Alejo-end/midiguitar/reins-guitar/renders/reins-guitar-bottom.png

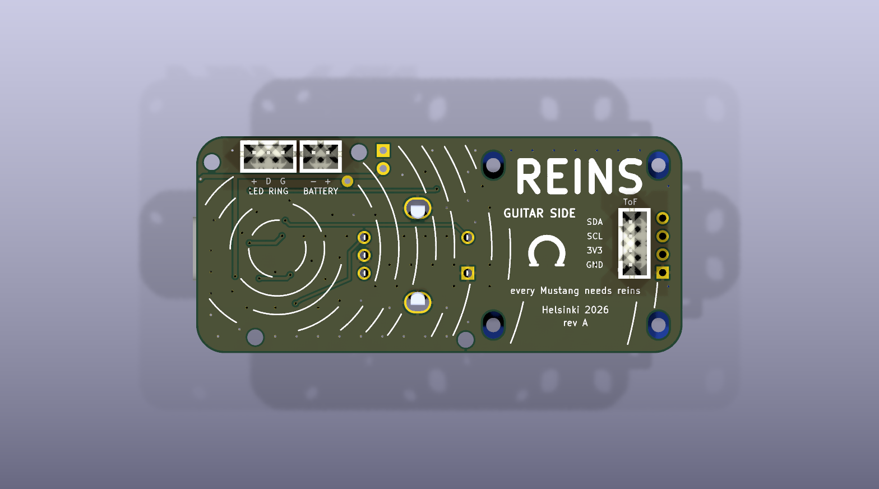
reins-guitar/renders/reins-guitar-bottom.png
