Alejo-end/midiguitar/reins-guitar/fab/jlc/reins-guitar/reins-guitar-bom.csv

Comment | Designator | Footprint | LCSC
100k | R4,R5 | R_0603_1608Metric | C25803
100nF | C1,C2,C4,C5 | C_0603_1608Metric | C14663
22uF | C3 | C_0805_2012Metric | C45783
330 | R1 | R_0603_1608Metric | C23138
B5819W | D1,D2 | D_SOD-123 | C8598
SN74LVC1T45DBVR | U1 | SOT-23-6 | C7843
