Alejo-end/midiguitar/cad/cad-midiguitar-guitar_043 (Solid)001.step

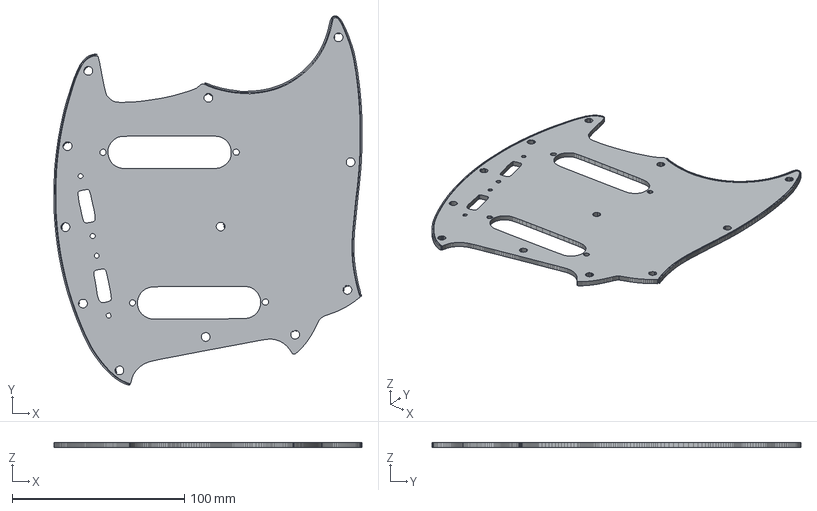
[picture p4: CAD file, 2026-05-04]
cad/cad-midiguitar-guitar_043 (Solid)001.step
179.0 x 214.4 x 3.00 mm
