Alejo-end/midiguitar/pcb/finalMidiGuitar.step

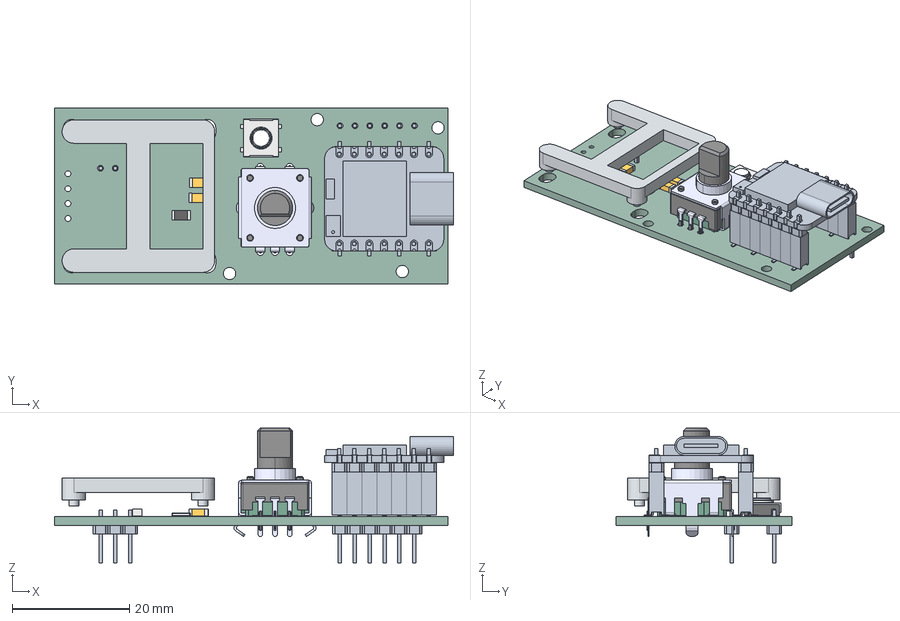
[picture p5: CAD file, 2026-05-04]
pcb/finalMidiGuitar.step
68.0 x 29.9 x 23.0 mm
Contact x 3
ContactClone x 3
finalMidiGuitar 1.2.1
finalMidiGuitar 1.2.2
finalMidiGuitar 1.2.3
finalMidiGuitar 1.2.4
finalMidiGuitar 1.2.5
finalMidiGuitar 1.2.6
finalMidiGuitar 1.2.7
Base
Lead
Button
Cover
Ceramic
Contacts
Contacts (Mirror #1)
Overcoat
PEC12R-4015F-S0024
finalMidiGuitar 1.7.1
finalMidiGuitar 1.7.2
finalMidiGuitar 1.8.1
finalMidiGuitar 1.8.2
finalMidiGuitar 1.8.3
OLEDStand
finalMidiGuitar_PCB
