Alejo-end/midiguitar/reins-guitar/3dmodels/SW_SPST_B3S-1000.step

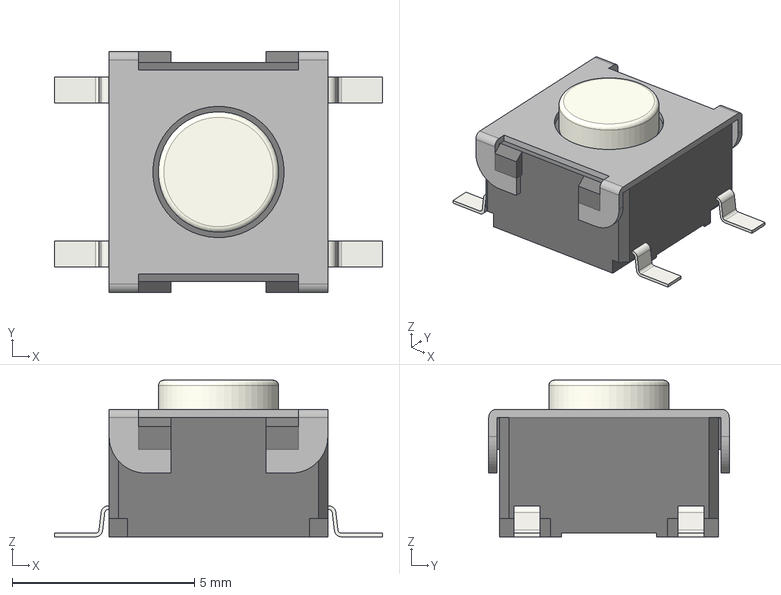
[picture p6: CAD file, 2026-10-11]
reins-guitar/3dmodels/SW_SPST_B3S-1000.step
9.00 x 6.60 x 4.30 mm
