Alejo-end/midiguitar/reins-guitar/3dmodels/Seeed_XIAO-Generic_InSocket_SMD.step

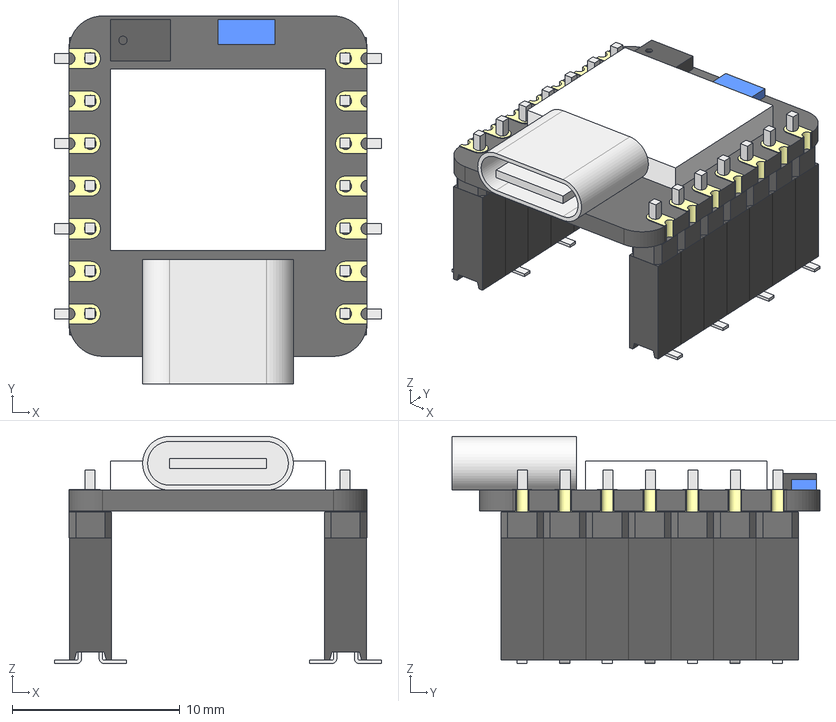
[picture p7: CAD file, 2026-10-11]
reins-guitar/3dmodels/Seeed_XIAO-Generic_InSocket_SMD.step
19.5 x 22.0 x 13.6 mm
SoC_nRF_Sense001
Mic_nRF_Sense001
Antenna_nRF_Sense001
Board001
USB001
Contact001
Lead003
Lead004
Lead005
Lead006
Lead007
Lead008
Lead009
Lead010
Lead011
Lead012
Lead013
Lead014
Lead015
Lead016
PinHeader021
PinHeader022
PinHeader023
PinHeader024
PinHeader025
PinHeader026
PinHeader027
PinHeader028
PinHeader029
PinHeader030
PinHeader031
PinHeader032
PinHeader033
PinHeader034
