Alejo-end/midiguitar/reins-guitar/3dmodels/SSD1306_OLED_Module.step

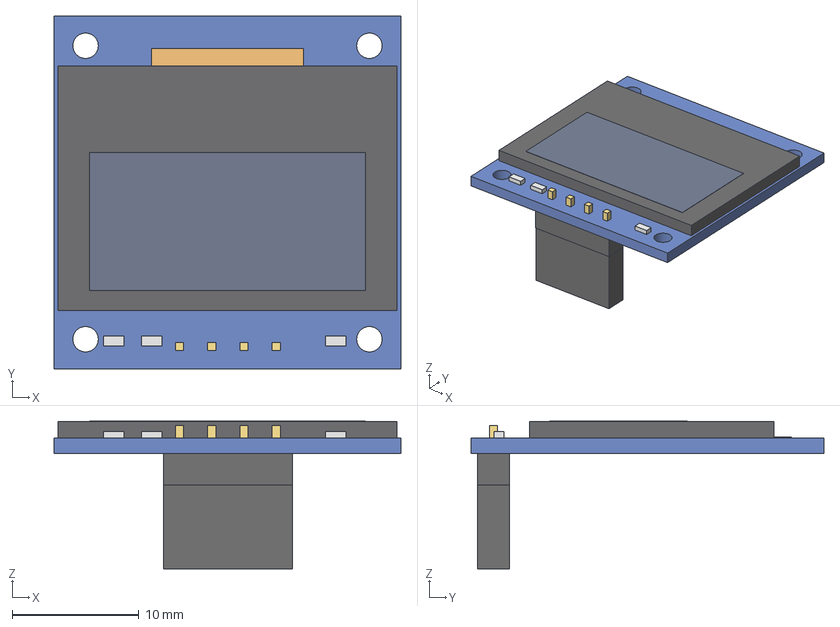
[picture p8: CAD file, 2026-10-11]
reins-guitar/3dmodels/SSD1306_OLED_Module.step
27.3 x 27.8 x 11.6 mm
pcb
glass
pixels
fpc
socket
header
pins
parts
