Alejo-end/midiguitar/reins-guitar/3dmodels/PEC12R-4015F-S0024.step

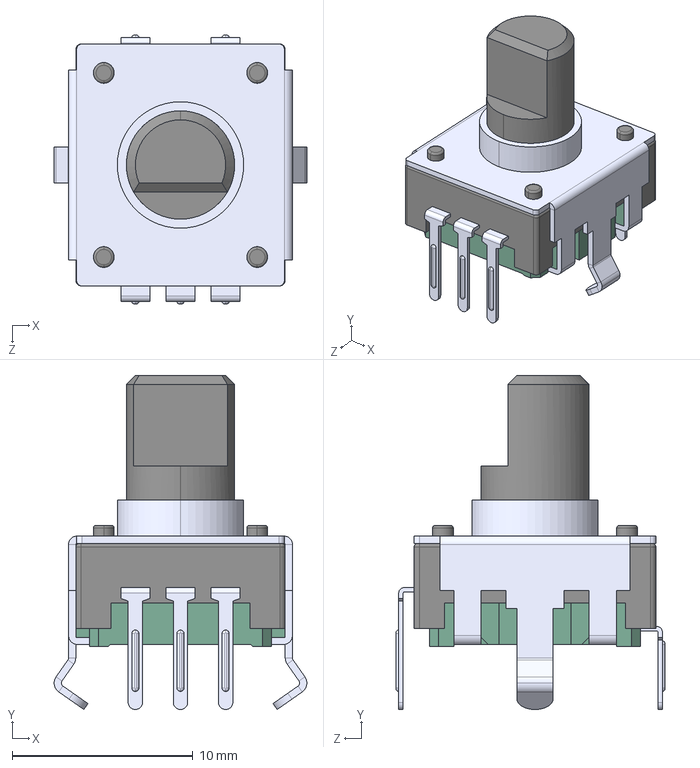
[picture p9: CAD file, 2026-10-11]
reins-guitar/3dmodels/PEC12R-4015F-S0024.step
14.0 x 18.5 x 14.9 mm
