Alejo-end/midiguitar/reins-guitar/reins-guitar.kicad_pcb

## KiCad design reins-guitar/reins-guitar.kicad_pcb (2026-10-11)

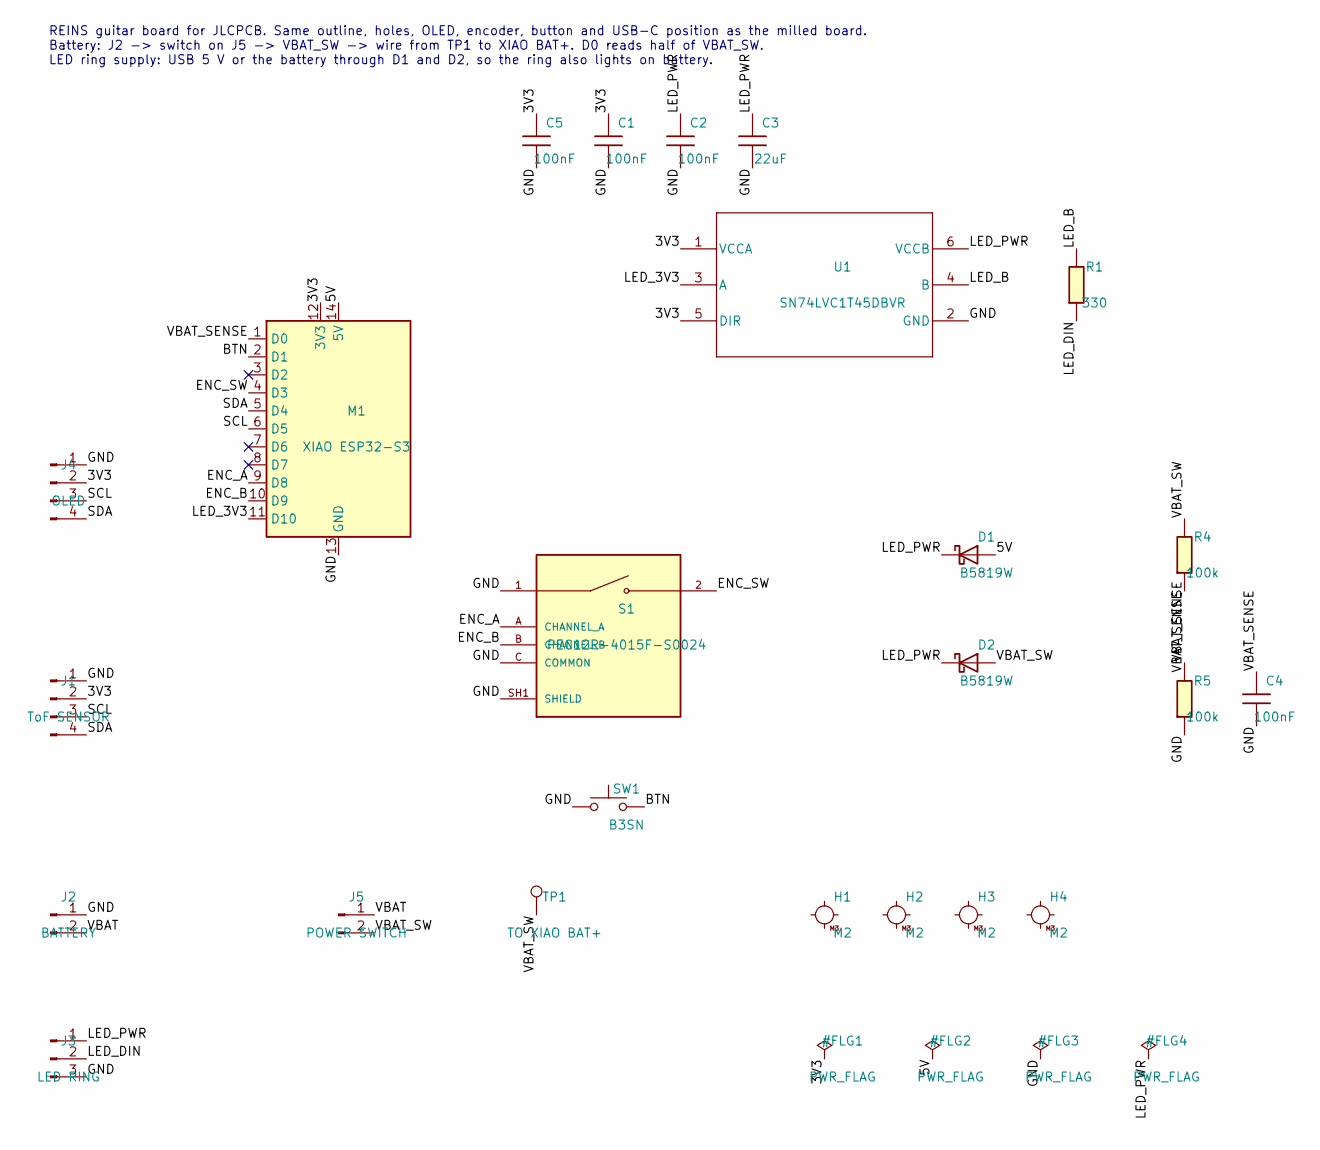
[picture p10: schematic reins-guitar.kicad_sch, REINS guitar board (JLCPCB)]

Parts:
C1, C2, C4, C5: 100nF; C_0603_1608Metric; LCSC C14663
C3: 22uF; C_0805_2012Metric; LCSC C45783
D1, D2: B5819W; D_SOD-123; LCSC C8598
H1, H2, H3, H4: M2; MountingHole_2.2mm_M2_Head3.8mm
J1: ToF SENSOR; JST_PH_B4B-PH-K_1x04_P2.00mm_Vertical
J2: BATTERY; JST_PH_B2B-PH-K_1x02_P2.00mm_Vertical
J3: LED RING; JST_PH_B3B-PH-K_1x03_P2.00mm_Vertical
J4: OLED; OLED_SSD1306_0.96in_I2C_THT
J5: POWER SWITCH; WirePads_1x02_P2.54mm
M1: XIAO ESP32-S3; Module_XIAO_Generic_SocketSMD
R1: 330; R_0603_1608Metric; LCSC C23138
R4, R5: 100k; R_0603_1608Metric; LCSC C25803
S1: PEC12R-4015F-S0024; RotaryEncoder_Bourns_PEC12R-4xxxF-S
SW1: B3SN; SW_Omron_B3SN_6x6mm_Diagonal
TP1: TO XIAO BAT+; WirePad_THT_D1.6mm_Drill0.8mm
U1: SN74LVC1T45DBVR; SOT-23-6; LCSC C7843

Connections:
/3V3: C1.1, C5.1, J1.2, J4.2, M1.12 (3V3), U1.1 (VCCA), U1.5 (DIR)
/5V: D1.2 (A), M1.14 (5V)
/BTN: M1.2 (D1), SW1.2
/ENC_A: M1.9 (D8), S1.A (CHANNEL_A)
/ENC_B: M1.10 (D9), S1.B (CHANNEL_B)
/ENC_SW: M1.4 (D3), S1.2
/GND: C1.2, C2.2, C3.2, C4.2, C5.2, J1.1, J2.1, J3.3, J4.1, M1.13 (GND), R5.2, S1.1, S1.C (COMMON), S1.SH1 (SHIELD), S1.SH2 (SHIELD), SW1.1, U1.2 (GND)
/LED_3V3: M1.11 (D10), U1.3 (A)
/LED_B: R1.1, U1.4 (B)
/LED_DIN: J3.2, R1.2
/LED_PWR: C2.1, C3.1, D1.1 (K), D2.1 (K), J3.1, U1.6 (VCCB)
/SCL: J1.3, J4.3, M1.6 (D5)
/SDA: J1.4, J4.4, M1.5 (D4)
/VBAT: J2.2, J5.1
/VBAT_SENSE: C4.1, M1.1 (D0), R4.2, R5.1
/VBAT_SW: D2.2 (A), J5.2, R4.1, TP1.1

Notes on the sheet:
REINS guitar board for JLCPCB. Same outline, holes, OLED, encoder, button and USB-C position as the milled board. Battery: J2 -> switch on J5 -> VBAT_SW -> wire from TP1 to XIAO BAT+. D0 reads half of VBAT_SW. LED ring supply: USB 5 V or the battery through D1 and D2, so the ring also lights on bat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

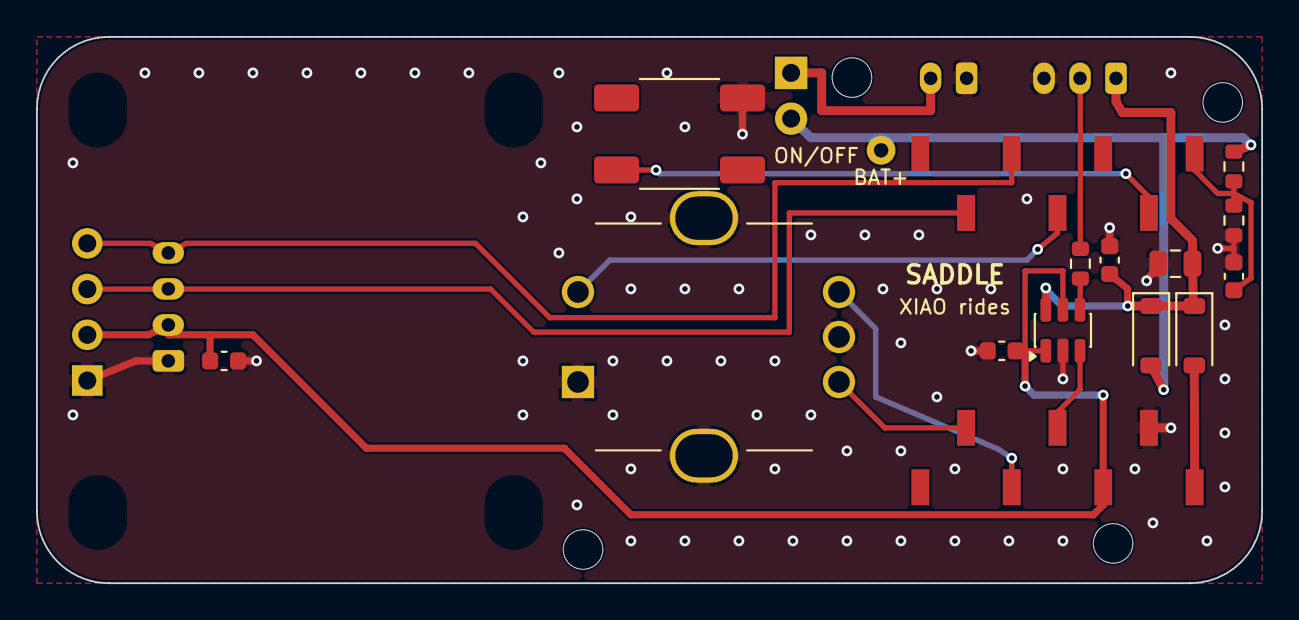
[picture p11: board reins-guitar.kicad_pcb from above]

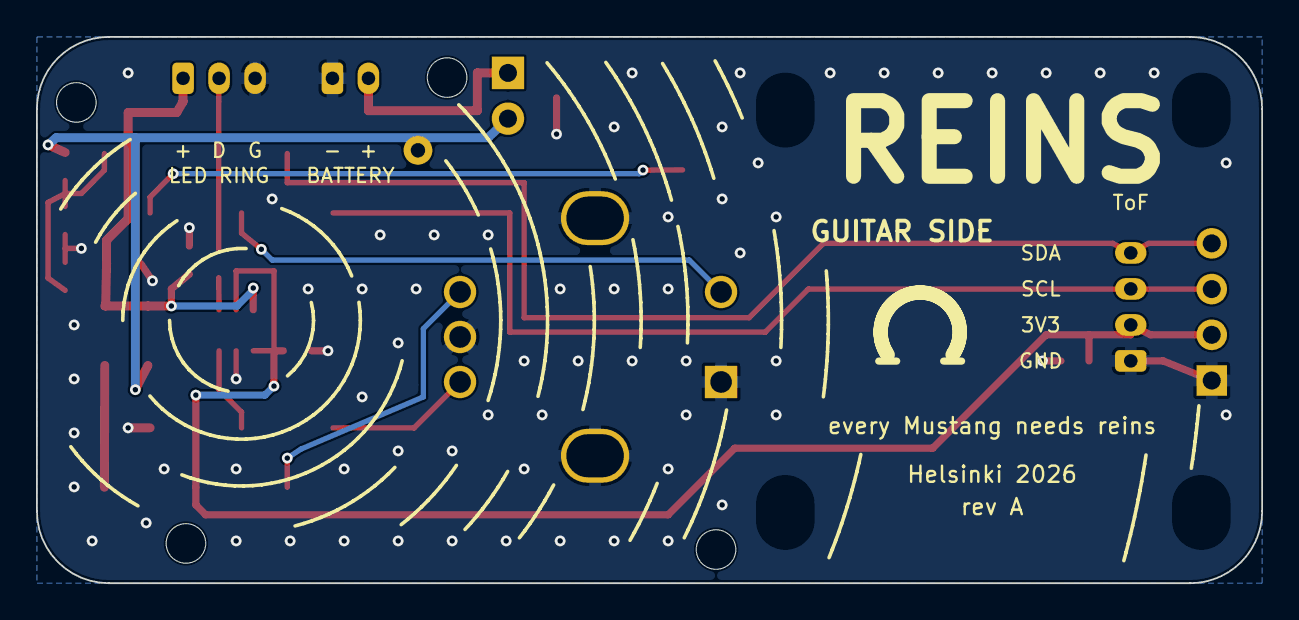
[picture p12: board reins-guitar.kicad_pcb from below]

Board: 2 copper layers, 68.1 x 30.3 mm, 24 parts (3 on the bottom side), 16 nets.
