Alejo-end/midiguitar/finalMidiGuitar2/finalMidiGuitar2.kicad_pcb

## KiCad design finalMidiGuitar2/finalMidiGuitar2.kicad_pcb (2026-04-26)

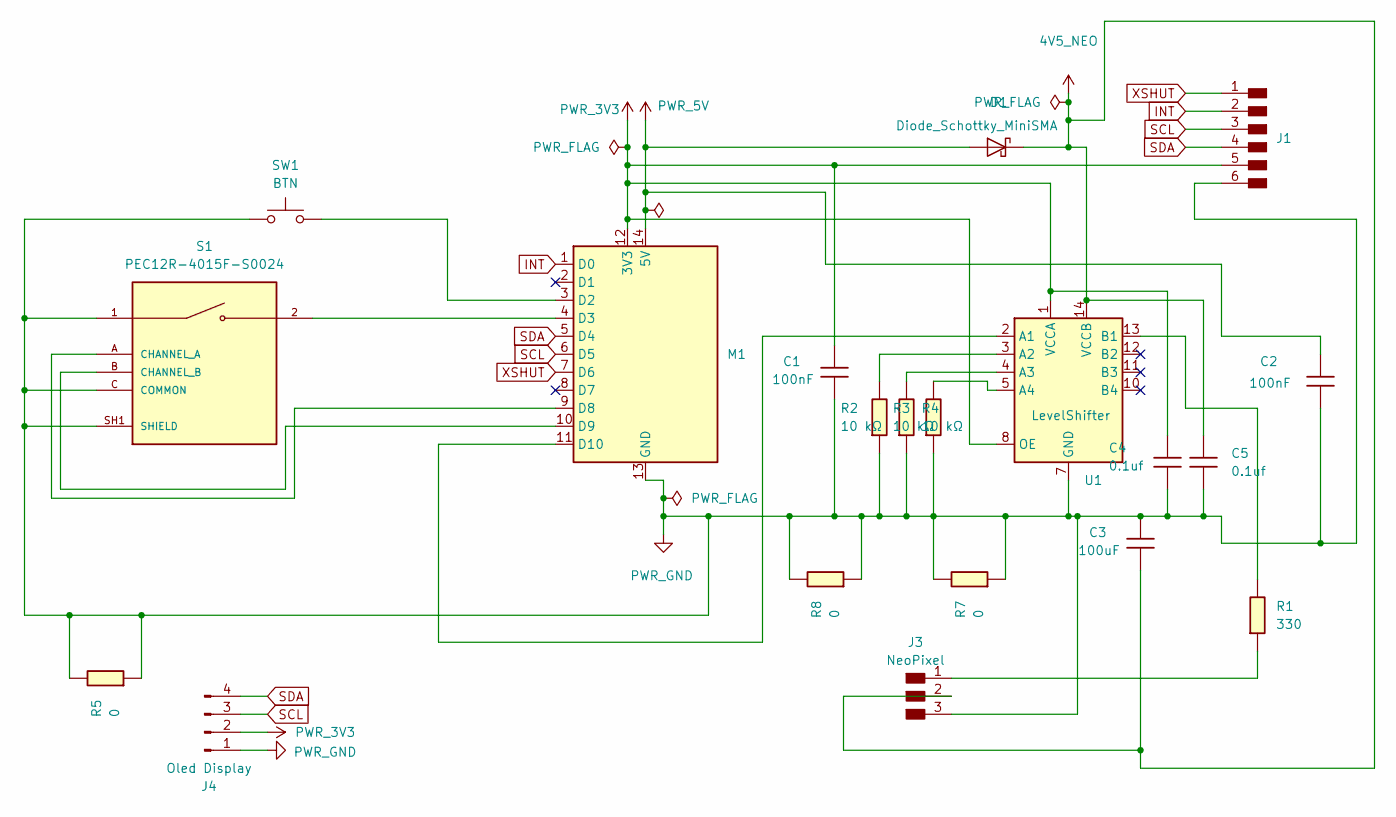
[picture p13: schematic finalMidiGuitar2.kicad_sch]

Parts:
C1, C2: 100nF; C_1206
C3: 100uF; C_1206
C4, C5: 0.1uf; C_1206
D1: Diode_Schottky_MiniSMA
J1: PinHeader_01x06_P2.54mm_Vertical_THT_D1mm
J3: NeoPixel; PinHeader_01x03_P2.54mm_Vertical_THT_D1mm
J4: Oled Display; Display_128x64_096_I2C
M1: Module_XIAO_Generic_SocketSMD
R1: 330; R_1206
R2, R3, R4: 10 kΩ; R_1206
R5, R7, R8: 0; R_1206
S1: PEC12R-4015F-S0024; XDCR_PEC12R-4015F-S0024; PARTREV 07/21
SW1: BTN; Button_Omron_B3SN_6.0x6.0mm
U1: LevelShifter; LevelShifter_Texas_TXB0104DR_SOIC-14

Connections:
4V5_NEO: C3.2, C5.1, D1.1 (K), J3.2, U1.14 (VCCB)
INT: J1.2, M1.1 (D0)
unnamed: J3.1, R1.2
unnamed: M1.3 (D2), SW1.2
unnamed: M1.4 (D3), S1.2
unnamed: M1.9 (D8), S1.A (CHANNEL_A)
unnamed: M1.10 (D9), S1.B (CHANNEL_B)
unnamed: M1.11 (D10), U1.2 (A1)
unnamed: R2.1, U1.3 (A2)
unnamed: R3.1, U1.4 (A3)
unnamed: R4.1, U1.5 (A4)
unnamed: R1.1, U1.13 (B1)
PWR_3V3: C1.1, C4.1, J1.5, J4.2, M1.12 (3V3), U1.1 (VCCA), U1.8 (OE)
PWR_5V: C2.1, D1.2 (A), M1.14 (5V)
PWR_GND: C1.2, C2.2, C3.1, C4.2, C5.2, J1.6, J3.3, J4.1, M1.13 (GND), R2.2, R3.2, R4.2, R5.1, R5.2, R7.1, R7.2, R8.1, R8.2, S1.1, S1.C (COMMON), S1.SH1 (SHIELD), S1.SH2 (SHIELD), SW1.1, U1.7 (GND)
SCL: J1.3, J4.3, M1.6 (D5)
SDA: J1.4, J4.4, M1.5 (D4)
XSHUT: J1.1, M1.7 (D6)

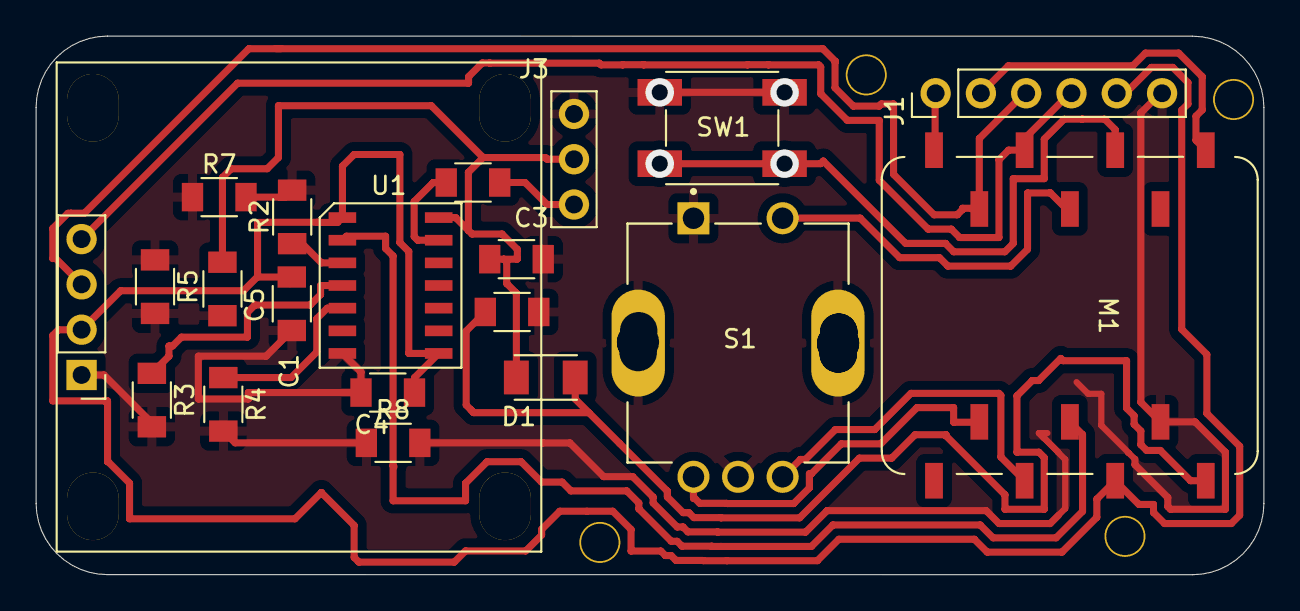
[picture p14: board finalMidiGuitar2.kicad_pcb from above]

Board: 2 copper layers, 68.9 x 30.2 mm, 20 parts (0 on the bottom side), 18 nets.
