Alejo-end/midiguitar/failed attemps/rightZise/midiguitar-right-size.kicad_pcb

## KiCad design failed attemps/rightZise/midiguitar-right-size.kicad_pcb (2026-04-14)

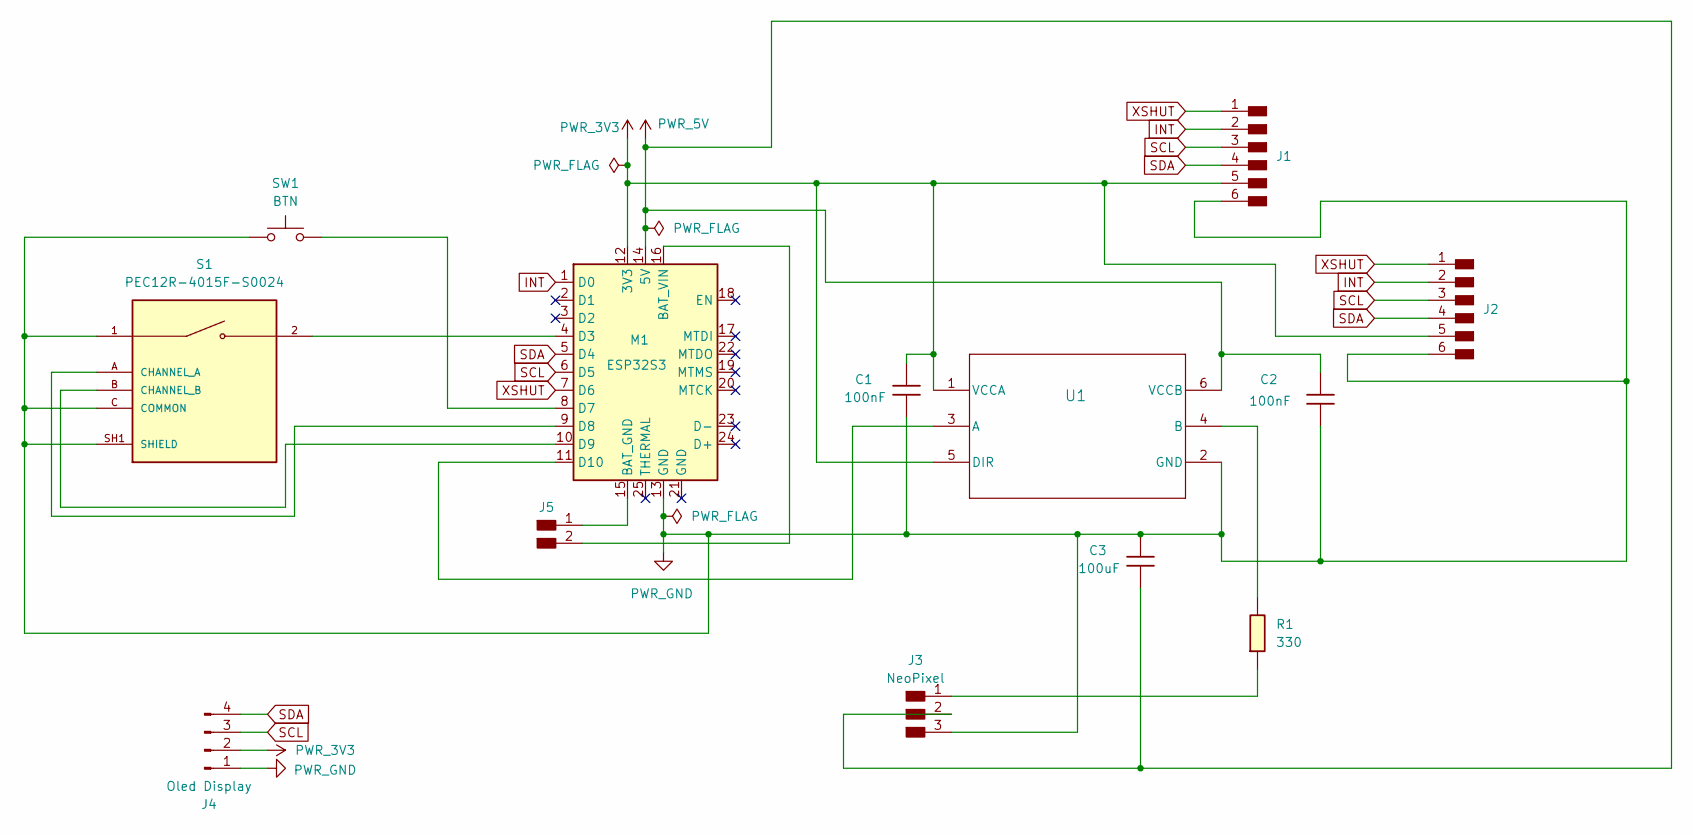
[picture p15: schematic midiguitar-right-size.kicad_sch]

Parts:
C1, C2: 100nF; C_1206
C3: 100uF; C_1206
J1, J2: PinHeader_01x06_P2.54mm_Vertical_THT_D1mm
J3: NeoPixel; PinHeader_01x03_P2.54mm_Vertical_THT_D1mm
J4: Oled Display; Display_128x64_096_I2C
J5: PinHeader_01x02_P2.54mm_Vertical_THT_D1mm
M1: ESP32S3; SeeedStudio_XIAO_ESP32S3
R1: 330; R_1206
S1: PEC12R-4015F-S0024; XDCR_PEC12R-4015F-S0024; PARTREV 07/21
SW1: BTN; Button_Omron_B3SN_6.0x6.0mm
U1: SN74LVC1T45DBVR; DBV0006A_N

Connections:
INT: J1.2, J2.2, M1.1 (D0)
unnamed: J3.1, R1.2
unnamed: J5.1, M1.15 (BAT_GND)
unnamed: J5.2, M1.16 (BAT_VIN)
unnamed: M1.4 (D3), S1.2
unnamed: M1.8 (D7), SW1.2
unnamed: M1.9 (D8), S1.A (CHANNEL_A)
unnamed: M1.10 (D9), S1.B (CHANNEL_B)
unnamed: M1.11 (D10), U1.3 (A)
unnamed: R1.1, U1.4 (B)
PWR_3V3: C1.1, J1.5, J2.5, J4.2, M1.12 (3V3), U1.1 (VCCA), U1.5 (DIR)
PWR_5V: C2.1, C3.2, J3.2, M1.14 (5V), U1.6 (VCCB)
PWR_GND: C1.2, C2.2, C3.1, J1.6, J2.6, J3.3, J4.1, M1.13 (GND), M1.21 (GND), S1.1, S1.C (COMMON), S1.SH1 (SHIELD), S1.SH2 (SHIELD), SW1.1, U1.2 (GND)
SCL: J1.3, J2.3, J4.3, M1.6 (D5)
SDA: J1.4, J2.4, J4.4, M1.5 (D4)
XSHUT: J1.1, J2.1, M1.7 (D6)

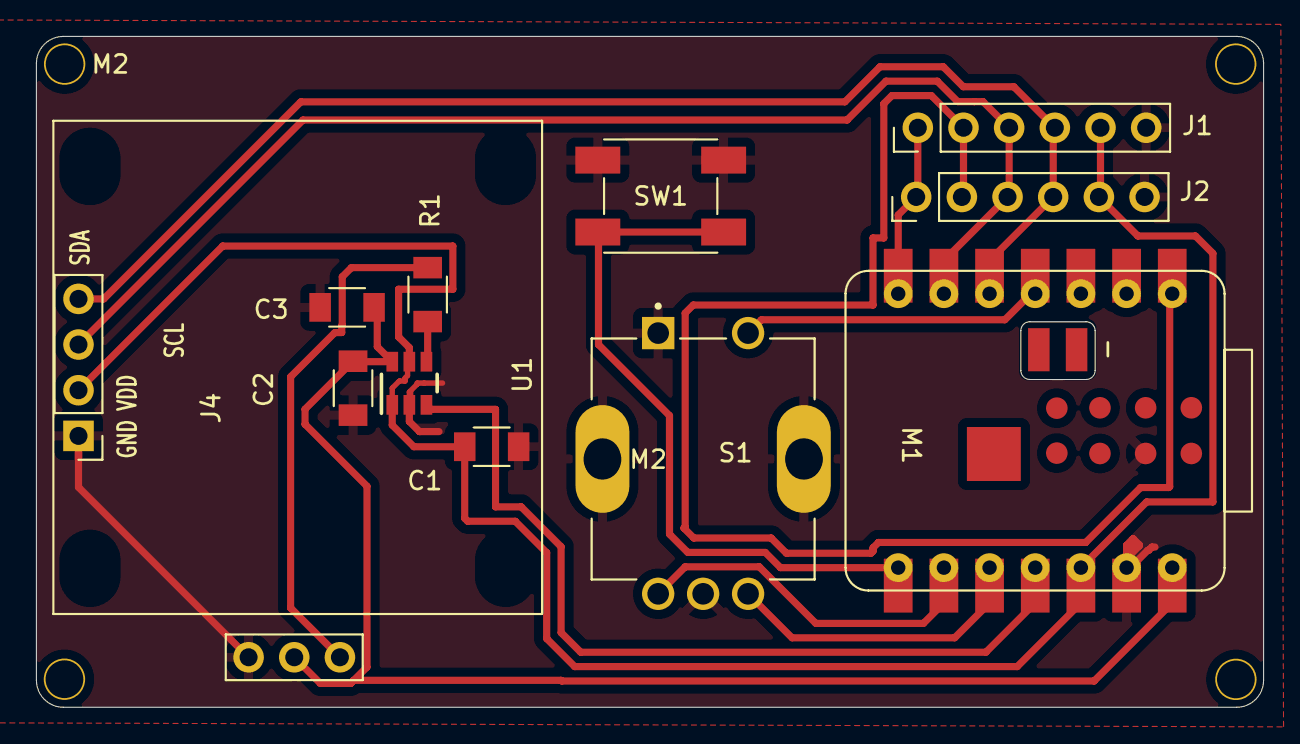
[picture p16: board midiguitar-right-size.kicad_pcb from above]

Board: 2 copper layers, 68.2 x 37.3 mm, 12 parts (0 on the bottom side), 14 nets.
