Alejo-end/midiguitar/(commit log)

2026-04-01 Initial commit: MIDI guitar project with KiCad schematics and Arduino firmware
2026-04-01 Refactor tof_midi.ino for improved clarity and organization; update comments and streamline sensor initialization
2026-04-02 Update README.md for enhanced clarity and detail; refine hardware and wiring sections, and improve MIDI output descriptions.
2026-04-02 Enhance README.md with detailed system overview and signal flow diagrams; add pickguard layout for better hardware understanding.
2026-04-02 Remove system overview and signal flow diagrams from README.md for simplification
2026-04-04 Updated `midiguitar.kicad_pro` with detailed design settings and Introduced a new symbol library table in `sym-lib-table` for `midiguitar-eagle-import`.
2026-04-14 Refactor button and transport pin definitions; remove bypass functionality
2026-04-15 Add sensor interrupt handling and enhance button functionality for context-sensitive actions
2026-04-20 Update pad dimensions and clean up schematic and pcb
2026-04-20 Refactor hardware pin definitions for clarity and consistency
2026-04-23 Add lock files for PCB and schematic in finalMidiGuitar2 project
2026-04-24 Remove lock files for KiCad PCB and schematic
2026-04-26 Add new CAD and backup files for Midi Guitar project
2026-05-04 Add web UI HTML and build script for MIDI Guitar interface
    - Introduced `web_ui.html` as the main HTML file for the MIDI Guitar interface, including layout and styling.
    - Created `build_web_ui.sh` script to generate a header file `web_ui_html.h` from `web_ui.html`, stripping unnecessary comments and wrapping the content in a PROGMEM raw-string for ESP32 compatibility.
    - The script ensures that the generated header file is automatically updated when changes are made to the HTML source.
2026-05-05 Add label "Midi Guitar" to the schematic for better identification
2026-05-15 Update README and code comments for clarity on encoder gestures and WiFi config
2026-10-11 Receiver: TRS MIDI out on D6, swap MUTE and MODE pins
    The Heat receiver board now has a 3.5 mm TRS type A MIDI OUT jack on D6
    (GPIO43) and a footswitch jack wired in parallel with the MUTE button.
    Only the D1 track could reach the footswitch, so MUTE moves to D1 and
    MODE to D0; the board silkscreen matches. Every message sent over USB
    MIDI is mirrored to Serial1 at 31250 baud. Builds for the XIAO ESP32-S3.
2026-10-11 Receiver comments: MIDI OUT is a 5-pin DIN socket now
2026-10-11 Receiver: expression pedal on D2 sends CC 11
    The REINS jack board feeds a stereo 6.35 mm jack: tip to D2 through
    10k and 100 nF, ring from 3V3 through 200 ohm. D2 uses the internal
    pull-down, so an empty jack reads 0 V. The range is learned once the
    pedal has moved over 20 % of its travel. The LIVE page shows EXP.
2026-10-11 Receiver: HOLD footswitch on D7, latching MUTE footswitch
    D7 (GPIO44) reads the ring of the FOOT jack. While it is down, the local
    ToF and expression CCs stay frozen. MUTE toggles on each press and also on
    the release of a press longer than 1 s, so a latching 3PDT gives one toggle
    per stomp. FOOT2_ENABLE 0 turns HOLD off for mono footswitch cables.
2026-10-11 REINS guitar board for JLCPCB, battery and button in the firmware
    reins-guitar/ keeps the outline, holes, OLED, encoder, button and USB-C
    position of finalMidiGuitar. Two layers, small parts for JLCPCB assembly,
    cable headers on the bottom side. Adds a LiPo with a switch, a battery
    divider on D0 and a diode OR so the LED ring also lights on battery. The
    button moves to D1 on diagonal pads, which fixes the stuck LOW of D2.
    The encoder tab slots follow the Bourns PEC12R sheet.
    tof_midi_v5: SW1 on D1 toggles mute, D0 shows the battery charge and a
    LOW BAT warning. Set BTN_PIN and BAT_PIN to -1 for the milled board.
2026-10-11 JLC export: through-hole parts stay out of the BOM
