Alejo-end/midiguitar/(notices)

Notices in the files:
reins-guitar/3dmodels/SW_SPST_B3S-1000.step:
Copyright (C) 2025, KiCAD
This work is licensed under the
[Creative Commons CC-BY-SA 4.0 License](https://creativecommons.org/licenses/by-sa/4.0/legalcode),
with the following exception:
project files under this or any other license agreement. However, if you wish to distribute
